Anorasharon/EdgeNav-X-STM32-Cortex-M4-Autonomous-Perception-Motion-Control-Platform-/motor_test.ioc

Mcu.UserName=STM32F446RETx
PA10.Signal=GPIO_Output
PA13.Signal=SYS_JTMS-SWDIO
PA14.Signal=SYS_JTCK-SWCLK
PA2.Signal=USART2_TX
PA3.Signal=USART2_RX
PA6.Signal=S_TIM3_CH1
PA7.Signal=S_TIM3_CH2
PA8.Signal=GPIO_Input
PB10.Signal=S_TIM2_CH3
PB3.Signal=GPIO_Output
PB4.Signal=GPIO_Output
PB5.Signal=GPIO_Output
PB8.Signal=I2C1_SCL
PB9.Signal=I2C1_SDA
