Anorasharon/EdgeNav-X-STM32-Cortex-M4-Autonomous-Perception-Motion-Control-Platform-/(commit log)

2026-05-29 Motor basic test with pwm
2026-06-12 Initial release - STM32 Cortex-M4 Autonomous Perception & Motion Control Platform
